oabuv/Digital-temperature-measurement-system-design/Components_calculation_and_diagrams.pdf

## Design Analog signal processing

In this task, one will design temperature sensor circuit, buffer circuit and differential amplifier circuit. The differential amplifier will be used to gain input voltage (-0.3V to 0.3V) to wanted level as in figure.

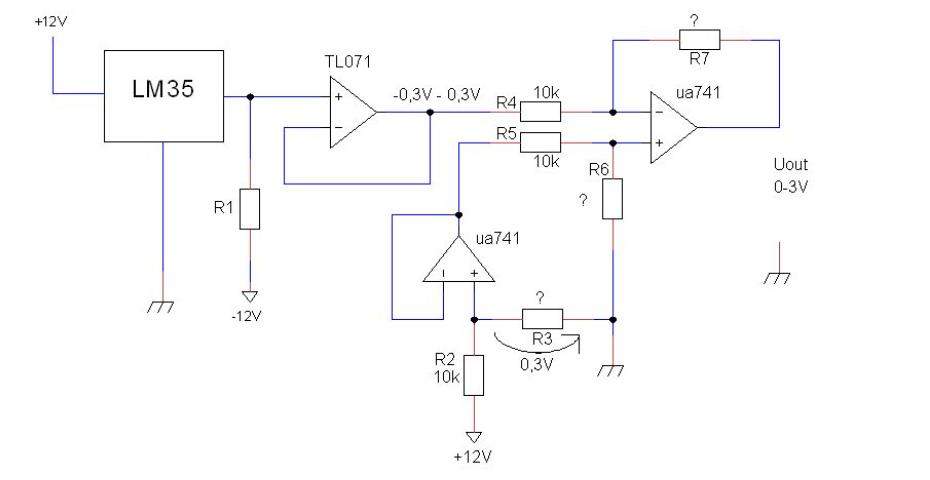
[picture p1: figure]

Analog signal processing circuit diagram

The sensor LM35 output voltage will change -0.3V to +0.3V when environment temperature changes from -30 Celsius to +30 Celsius.

We need to calculate the value of resistances:

Calculation of resistance R1

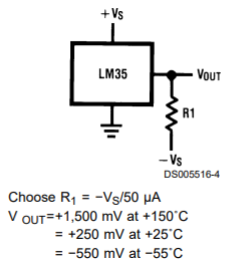
[picture p2: figure]

Full-range centigrade temperature sensor

From the datasheet of LM35, we have the equation of R1 as following:

R1 =

−Vs
50μA =

12V
50 × 10⁻⁶A

= 240000Ω = 240kΩ

Calculation of R3:

We have:

I2 =

12 − 0.3
10000 = 1.17 × 10⁻³A

And because I3 = I2, so that we can calculate R3 as follow:

R3 =

U3
I3

=

0.3V
1.17 × 10⁻³A

= 256,41Ω

Calculation of R6 and R7:

Because there is differential amplifier, so that: R6 = R7

and Uout =

−R7
R4

× (U1a − U1b

)

Indeed, we have that when the range is from -300mV to 300mV, the output should

become 3V to 0V. So, we have the equation of R7 as follow:

R7 = R6 = Uout ×

−R4
(−0.3 − 0.3)

= 3 ×

−10000Ω
−0.6

= 50kΩ

## Design communication processing

## Transmitter

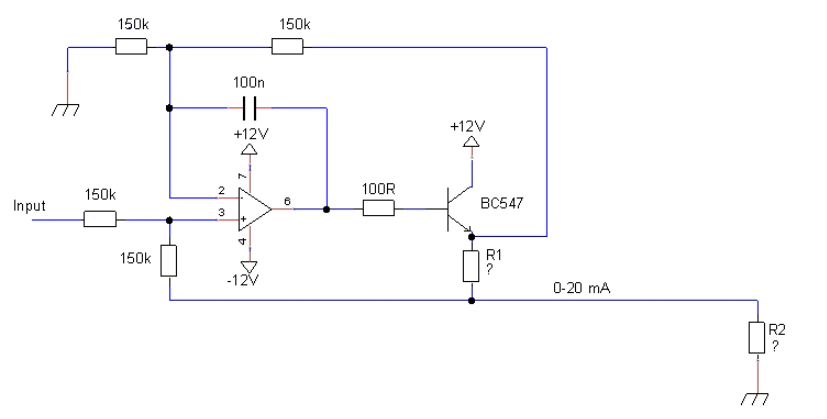
[picture p3: figure]

we have created an analog signal which depends on environment temperature (record through LM35), and the output voltage of the previous circuit is changing from 3V to 0V when the temperature is changing from -30 Celsius to +30 Celsius, respectively. And in this task, we will calculate the resistors so that we can have 0-20mA current through R1 when input voltage varies 0-3V DC.

Because when current 20mA flows in circuit the resistor R2 must have 5V over it, so we have equation to calculate R2 as follow:

R2 =

5V
20mA =

5V
20 × 10⁻³A

= 250Ω

From the circuit schematic, the input voltage varies from 0-3V, as the same result, the voltage through the resistor R1 is also varies from 0-3V, we have the equation to calculate R1 following:

R1 =

3V
20mA = 150Ω

The reason why we are using the current as analog signal instead of using voltage is because we can transfer the signal more far away consider of there will be much less signal loss on the way transfer.

Since the equation of resistor of the cable is R = ρ

l
A

, which ρ is a constant number depends on material of cable, and l is the length of cable, A is the area of cross section. By calculation, it is easy to see that, by normal cable, we can transfer the signal in a very long cable without the fear of losing the signal.

## Transmitter

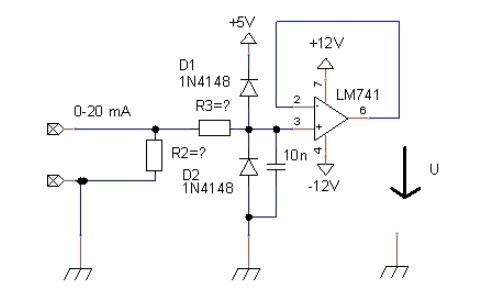
[picture p4: figure]

The R2 in this diagram is also the same R2 resistor in the transmitter diagram. In this receiver circuit, we will need to calculate the resistor of R3. If there is an input signal which contains 8kV ESD discharge voltage, and we do not want to have the current through D1 or D2 during this ESD event is bigger than 0.8A, so the resistor R3 needed to be calculated as following:

R3 =

UESD

IESD

=

8kV − 12V
0.8A

= 10kΩ

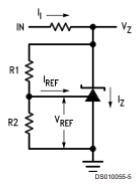
[picture p5: figure]

Circuit for Zener

## Analog to digital conversion

we will connect our analog signal (varies from 0-5V) and convert it into digital signal by using MCP3002. In the datasheet of MCP3002, the Vdd (reference voltage) should be 5V as condition. To achieve that, we need a reference chip LM431.

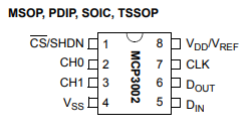
[picture p6: figure]

Pin of the ADC

First step, we need to build a feeder circuit for the LM431 (as shown in the right-hand side figure). The output voltage through this adjustable Zener shunt regulator will be Vz and is the reference voltage for out ADC. Vin will be the same as input voltage +12V for amplifier we were using. Now, we will need to calculate the resistor R which has II going through, and R2 when we give the value of R1 = 10kΩ.

To calculate R, we have the following equation:

R =

Vin − Vz
II

=

12V − 5V
10mA = 700Ω

Also, from the datasheet of LM431, we have Vref = 2.5V and Iref = 2μA (both typical values) and the equation as follow:

Vz = Vref × (1 +

R1
R2

) + Iref × R1

⇔ 5V = 2.5V × (1 +

10kΩ
R2

) + 2μA × 10kΩ

⇔ R2 = 10kΩ

So, from the calculated value of R and R2, we can build the analog to digital conversion circuit in bread board as follow:

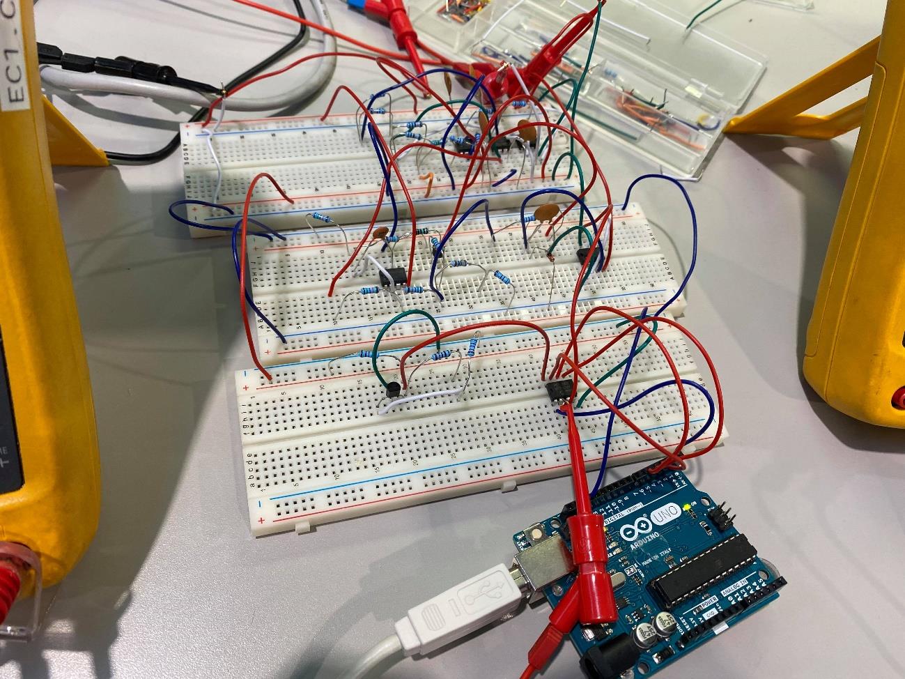
[picture p7: figure]
