oabuv/Digital-temperature-measurement-system-design/comunication_ltspice.asc

C1: cap; 10n
C2: cap; 100n
D1: diode; 1N4148
D2: diode; 1N4148
Lm35: voltage; 100m
Q1: npn; BC547B
R1: res; 250
R2: res; 10000
R3: res; 150k
R4: res; 150k
R5: res; 150k
R6: res; 150
R8: res; 150k
R9: res; 10k
R10: res; 256.4
R11: res; 10k
R12: res; 10k
R13: res; 50k
R14: res; 50k
R15: res; 100
U1: opamp2; LM741/NS
U2: opamp2; LM741/NS
U3: opamp2; LM741/NS
U4: opamp2; LM741/NS
U5: opamp2; TL071/301/TI
V3: voltage; 5
V4: voltage; 12
V5: voltage; 12
Named nets: VEE, VCC, 0, Vout, Vcomparition, Vin_receiver, Vout_receiver
.include nat_semi.lib
.include tex_inst.lib
.dc LM35 -300m 300m 10m
receiver
transmitter
