oabuv/Digital-temperature-measurement-system-design/(list of files, drawings)

Other design files:
transmitter_layout_complete.pcb
